Abi613/ESC/PCB/esc/Components/PolyFuse/README.md

Folyfuse model from here

https://eu.mouser.com/ProductDetail/Littelfuse/1206L035YR?qs=PWhpLWeW8wd%2F%252B9d2B1EXww%3D%3D
