Abi613/ESC/PCB/esc/Components/XL7015/README.md

Footprint and 3D model XL7015 from here

https://www.snapeda.com/parts/XL7015/XLSEMI/view-part/
