Abi613/ESC/PCB/esc/Components/Arduino/Arduino_Nano.STEP

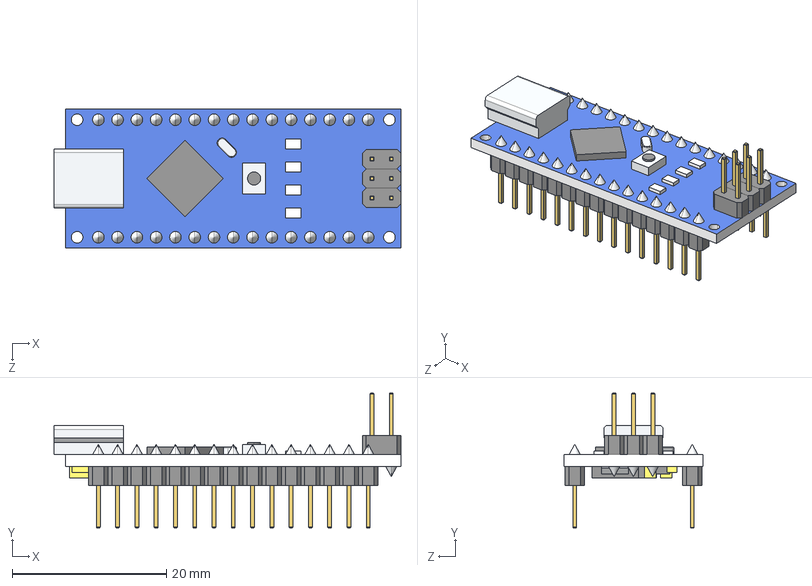
[picture p1: CAD file, 2025-10-23]
PCB/esc/Components/Arduino/Arduino_Nano.STEP
45.0 x 17.5 x 18.0 mm
