Abi613/ESC/PCB/esc/Components/CDRH104RNP/CDRH104RNP-150NC.STEP

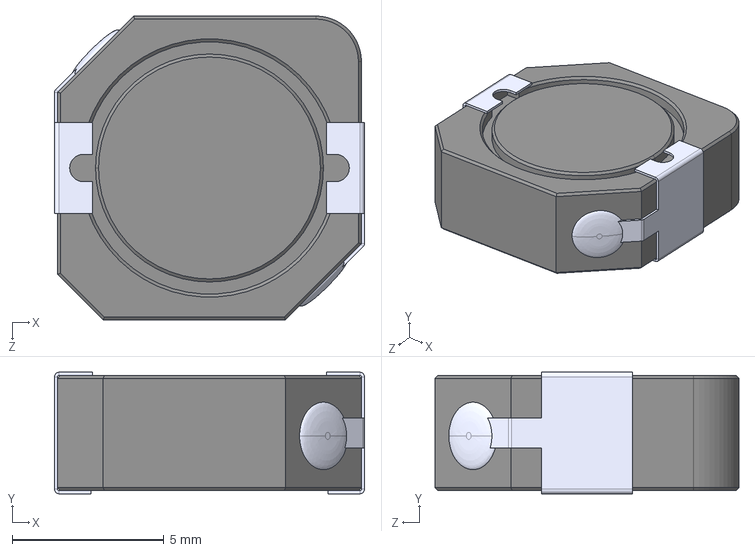
[picture p2: CAD file, 2025-10-23]
PCB/esc/Components/CDRH104RNP/CDRH104RNP-150NC.STEP
10.2 x 4.00 x 10.0 mm
