Abi613/ESC/PCB/esc/Components/Fuse Clips/3522-2--3DModel-STEP-56544.STEP

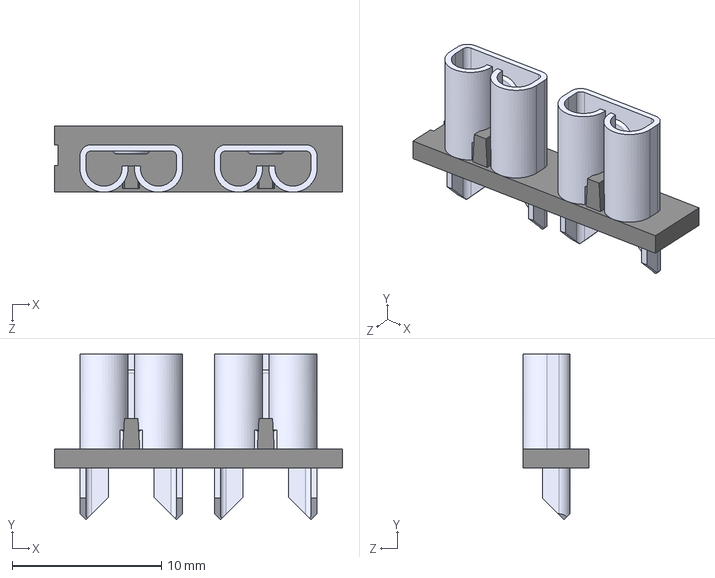
[picture p3: CAD file, 2025-10-23]
PCB/esc/Components/Fuse Clips/3522-2--3DModel-STEP-56544.STEP
19.3 x 11.1 x 4.45 mm
