Abi613/ESC/PCB/esc/Components/XL7015/XL7015.step

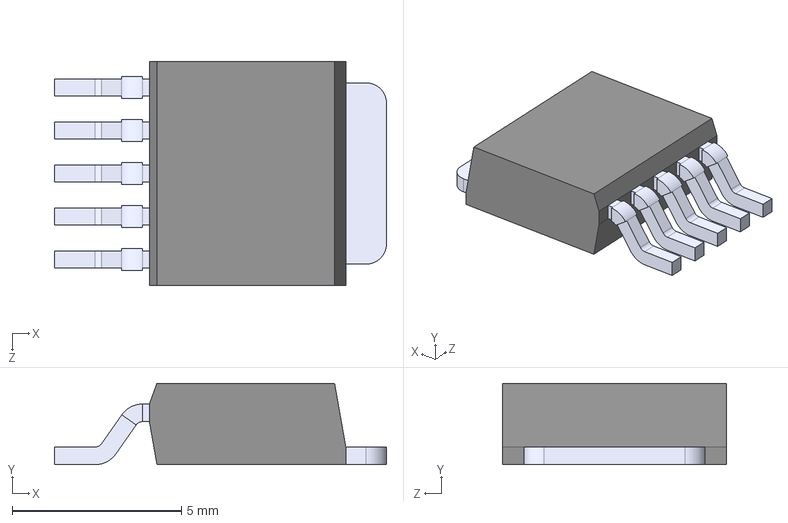
[picture p4: CAD file, 2025-10-23]
PCB/esc/Components/XL7015/XL7015.step
9.80 x 2.40 x 6.60 mm
