Abi613/ESC/PCB/esc/Components/PolyFuse/1206L035YR.stp

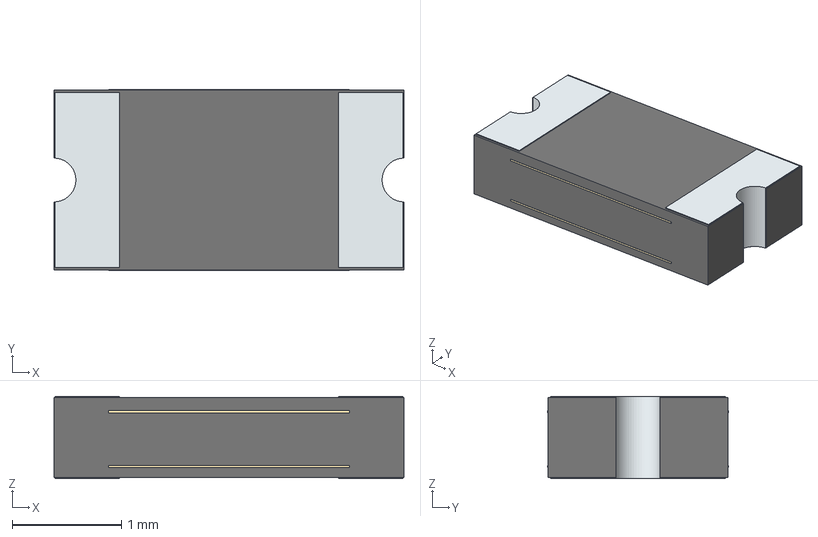
[picture p5: CAD file, 2025-10-23]
PCB/esc/Components/PolyFuse/1206L035YR.stp
3.20 x 1.65 x 0.75 mm
solidIntersect
Terminal
