Abi613/ESC/PCB/esc/Inverter.kicad_pcb

## KiCad design PCB/esc/Inverter.kicad_pcb (2025-11-30)

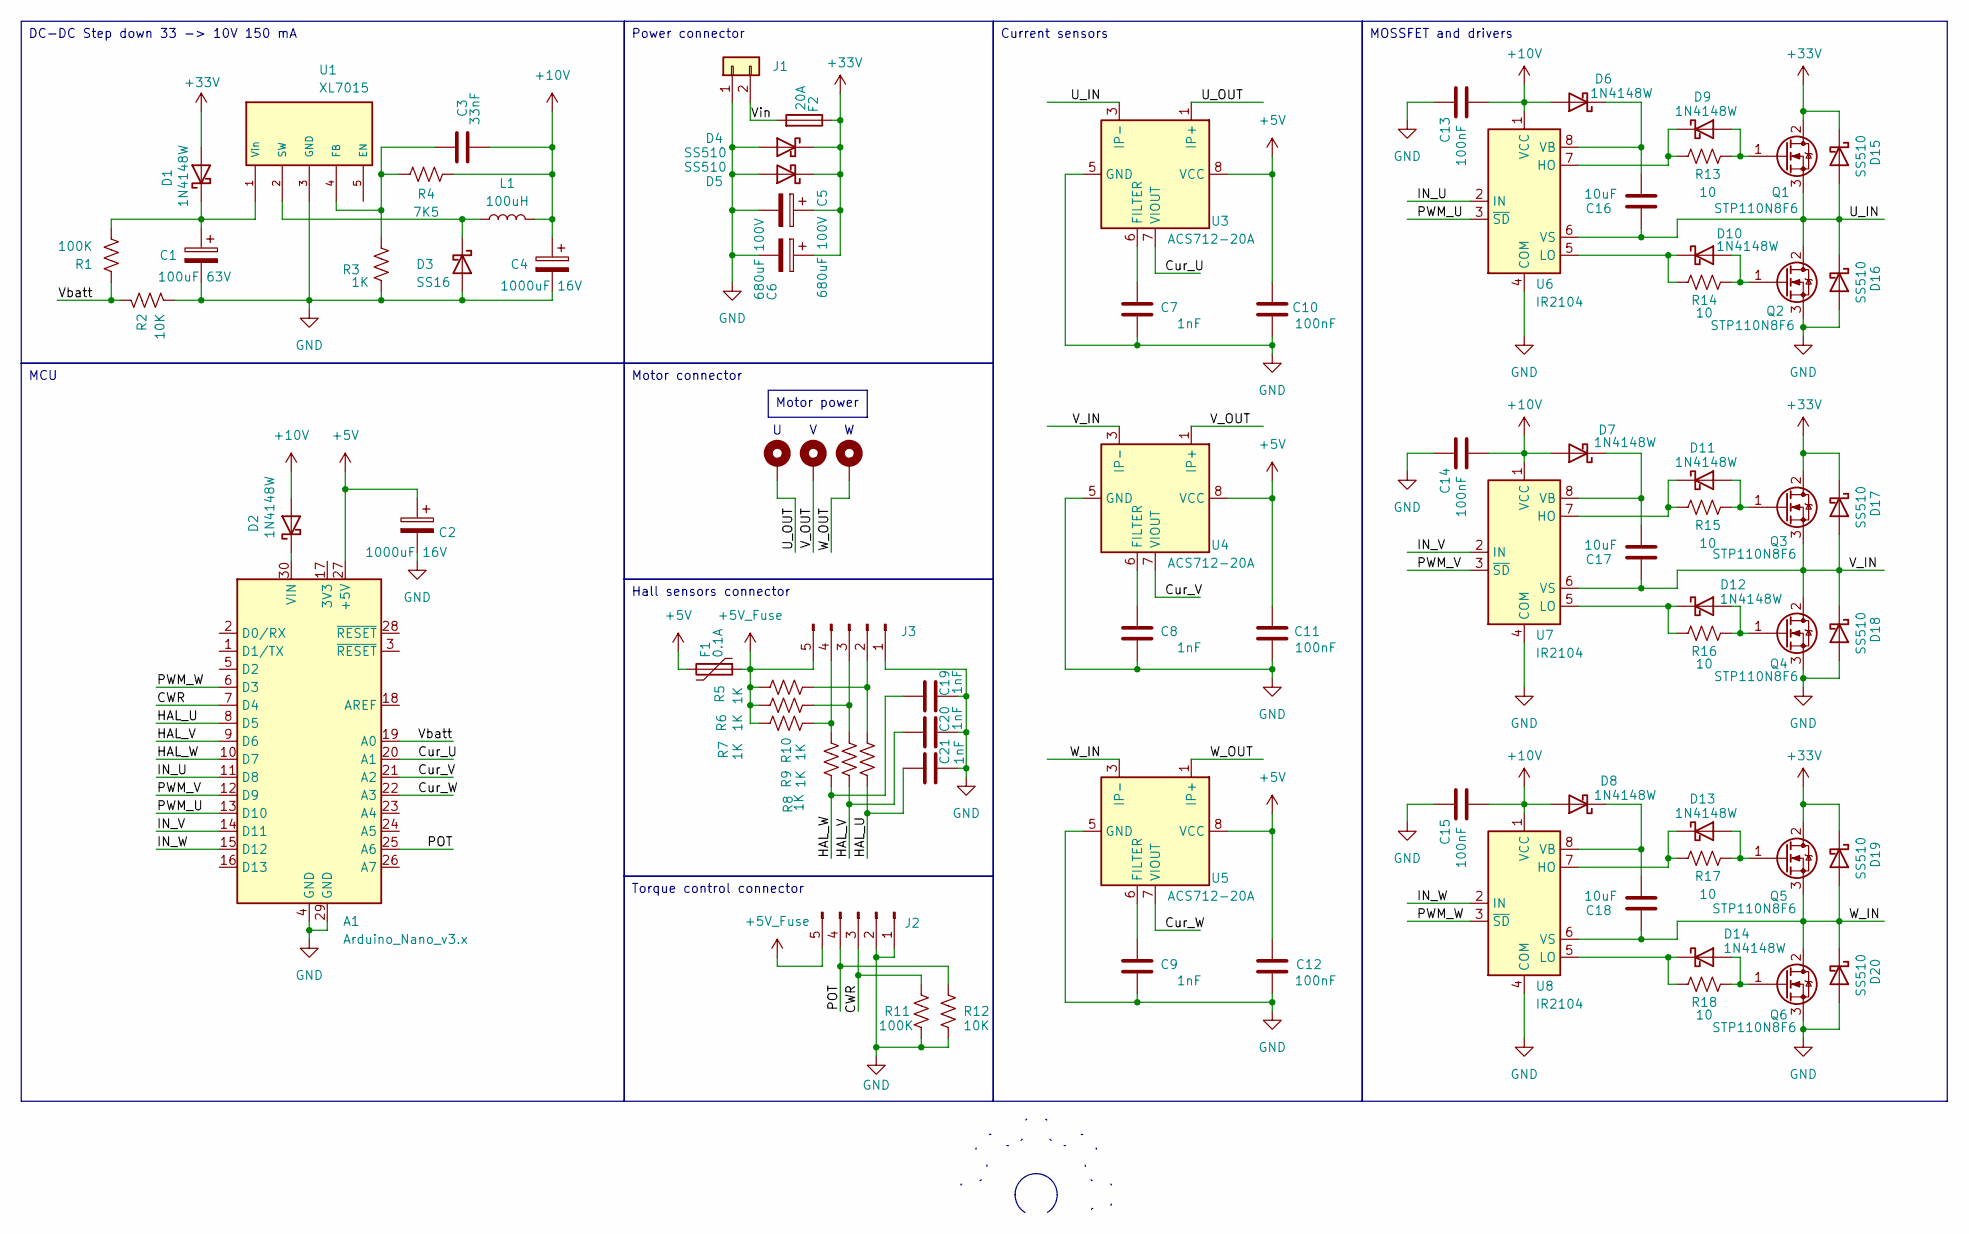
[picture p6: schematic Inverter.kicad_sch, Simple BLDC motor controller]

Parts:
A1: Arduino_Nano_v3.x; Arduino_Nano
C1: 100uF 63V; CP_Elec_10x10.5
C2, C4: 1000uF 16V; CP_Elec_10x10.5
C3: 33nF; C_0805_2012Metric_Pad1.18x1.45mm_HandSolder
C5, C6: 680uF 100V; CP_Radial_D16.0mm_P7.50mm
C7, C8, C9, C19, C20, C21: 1nF; C_0805_2012Metric_Pad1.18x1.45mm_HandSolder
C10, C11, C12, C13, C14, C15: 100nF; C_0805_2012Metric_Pad1.18x1.45mm_HandSolder
C16, C17, C18: 10uF; C_0805_2012Metric_Pad1.18x1.45mm_HandSolder
D1, D2, D6, D7, D8, D9, D10, D11, D12, D13, D14: 1N4148W; Nexperia_CFP3_SOD-123W
D3: SS16; D_SMA_Handsoldering
D4, D5, D15, D16, D17, D18, D19, D20: SS510; ST_D_SMC
F1: 0.1A; Fuse_1206_3216Metric
F2: 20A; FUSE_3522-2
J1: Conn_01x02; AMASS_XT60-M_1x02_P7.20mm_Vertical
J2, J3: Conn_01x05_Pin; JST_XH_B5B-XH-A_1x05_P2.50mm_Vertical
L1: 100uH; L_10.4x10.4_H4.8
Q1, Q2, Q3, Q4, Q5, Q6: STP110N8F6; TO-220-3_Horizontal_TabUp
R1, R11: 100K; R_0805_2012Metric_Pad1.20x1.40mm_HandSolder
R2, R12: 10K; R_0805_2012Metric_Pad1.20x1.40mm_HandSolder
R3, R5, R6, R7, R8, R9, R10: 1K; R_0805_2012Metric_Pad1.20x1.40mm_HandSolder
R4: 7K5; R_0805_2012Metric_Pad1.20x1.40mm_HandSolder
R13, R14, R15, R16, R17, R18: 10; R_0805_2012Metric_Pad1.20x1.40mm_HandSolder
U1: XL7015; TO-252-5_TabPin3
U2: MountingHole_Pad; MountingHole_2.2mm_M2_Pad
U3, U4, U5: ACS712-20A; SOIC-8_3.9x4.9mm_P1.27mm
U6, U7, U8: IR2104; SOIC-8_3.9x4.9mm_P1.27mm
V1: MountingHole_Pad; MountingHole_2.2mm_M2_Pad
W1: MountingHole_Pad; MountingHole_2.2mm_M2_Pad

Connections:
+5V: A1.27 (+5V), C2.1, C10.1, C11.1, C12.1, F1.2, U3.8 (VCC), U4.8 (VCC), U5.8 (VCC)
+5V_Fuse: F1.1, J2.5, J3.5, R5.2, R6.2, R7.2
+10V: C3.2, C4.1, C13.2, C14.2, C15.2, D2.2 (A), D6.2 (A), D7.2 (A), D8.2 (A), L1.2, R4.1, U6.1 (VCC), U7.1 (VCC), U8.1 (VCC)
+33V: C5.1, C6.1, D1.2 (A), D4.1 (K), D5.1 (K), D15.1 (K), D17.1 (K), D19.1 (K), F2.1, Q1.2 (D), Q3.2 (D), Q5.2 (D)
/CWR: A1.7 (D4), J2.3, R11.2
/Cur_U: A1.20 (A1), U3.7 (VIOUT)
/Cur_V: A1.21 (A2), U4.7 (VIOUT)
/Cur_W: A1.22 (A3), U5.7 (VIOUT)
/HAL_U: A1.8 (D5), C21.1, R10.1
/HAL_V: A1.9 (D6), C20.1, R9.1
/HAL_W: A1.10 (D7), C19.1, R8.1
/IN_U: A1.11 (D8), U6.2 (IN)
/IN_V: A1.14 (D11), U7.2 (IN)
/IN_W: A1.15 (D12), U8.2 (IN)
/POT: A1.25 (A6), J2.4, R12.2
/PWM_U: A1.13 (D10), U6.3 (~SD)
/PWM_V: A1.12 (D9), U7.3 (~SD)
/PWM_W: A1.6 (D3), U8.3 (~SD)
/U_IN: C16.1, D15.2 (A), D16.1 (K), Q1.3 (S), Q2.2 (D), U3.3 (IP-), U3.4 (IP-), U6.6 (VS)
/U_OUT: U2.1, U3.1 (IP+), U3.2 (IP+)
/V_IN: C17.1, D17.2 (A), D18.1 (K), Q3.3 (S), Q4.2 (D), U4.3 (IP-), U4.4 (IP-), U7.6 (VS)
/V_OUT: U4.1 (IP+), U4.2 (IP+), V1.1
/Vbatt: A1.19 (A0), R1.2, R2.2
/Vin: F2.2, J1.2
/W_IN: C18.1, D19.2 (A), D20.1 (K), Q5.3 (S), Q6.2 (D), U5.3 (IP-), U5.4 (IP-), U8.6 (VS)
/W_OUT: U5.1 (IP+), U5.2 (IP+), W1.1
GND: A1.4 (GND), A1.29 (GND), C1.2, C2.2, C4.2, C5.2, C6.2, C7.2, C8.2, C9.2, C10.2, C11.2, C12.2, C13.1, C14.1, C15.1, C19.2, C20.2, C21.2, D3.2 (A), D4.2 (A), D5.2 (A), D16.2 (A), D18.2 (A), D20.2 (A), J1.1, J2.1, J2.2, J3.1, Q2.3 (S), Q4.3 (S), Q6.3 (S), R2.1, R3.1, R11.1, R12.1, U1.3 (GND), U3.5 (GND), U4.5 (GND), U5.5 (GND), U6.4 (COM), U7.4 (COM), U8.4 (COM)
unnamed: A1.30 (VIN), D2.1 (K)
unnamed: C1.1, D1.1 (K), R1.1, U1.1 (Vin)
unnamed: D3.1 (K), L1.1, U1.2 (SW)
unnamed: C16.2, D6.1 (K), U6.8 (VB)
unnamed: C17.2, D7.1 (K), U7.8 (VB)
unnamed: C18.2, D8.1 (K), U8.8 (VB)
unnamed: D9.2 (A), Q1.1 (G), R13.1
unnamed: D9.1 (K), R13.2, U6.7 (HO)
unnamed: D10.2 (A), Q2.1 (G), R14.1
unnamed: D10.1 (K), R14.2, U6.5 (LO)
unnamed: D11.2 (A), Q3.1 (G), R15.1
unnamed: D11.1 (K), R15.2, U7.7 (HO)
unnamed: D12.2 (A), Q4.1 (G), R16.1
unnamed: D12.1 (K), R16.2, U7.5 (LO)
unnamed: D13.2 (A), Q5.1 (G), R17.1
unnamed: D13.1 (K), R17.2, U8.7 (HO)
unnamed: D14.2 (A), Q6.1 (G), R18.1
unnamed: D14.1 (K), R18.2, U8.5 (LO)
unnamed: J3.2, R5.1, R10.2
unnamed: J3.3, R6.1, R9.2
unnamed: J3.4, R7.1, R8.2
unnamed: C3.1, R3.2, R4.2, U1.4 (FB)
unnamed: C7.1, U3.6 (FILTER)
unnamed: C8.1, U4.6 (FILTER)
unnamed: C9.1, U5.6 (FILTER)

Notes on the sheet:
Power connector
Current sensors
MOSSFET and drivers
Motor connector
Hall sensors connector
Motor power
MCU
DC-DC Step down 33 -> 10V 150 mA
Torque control connector

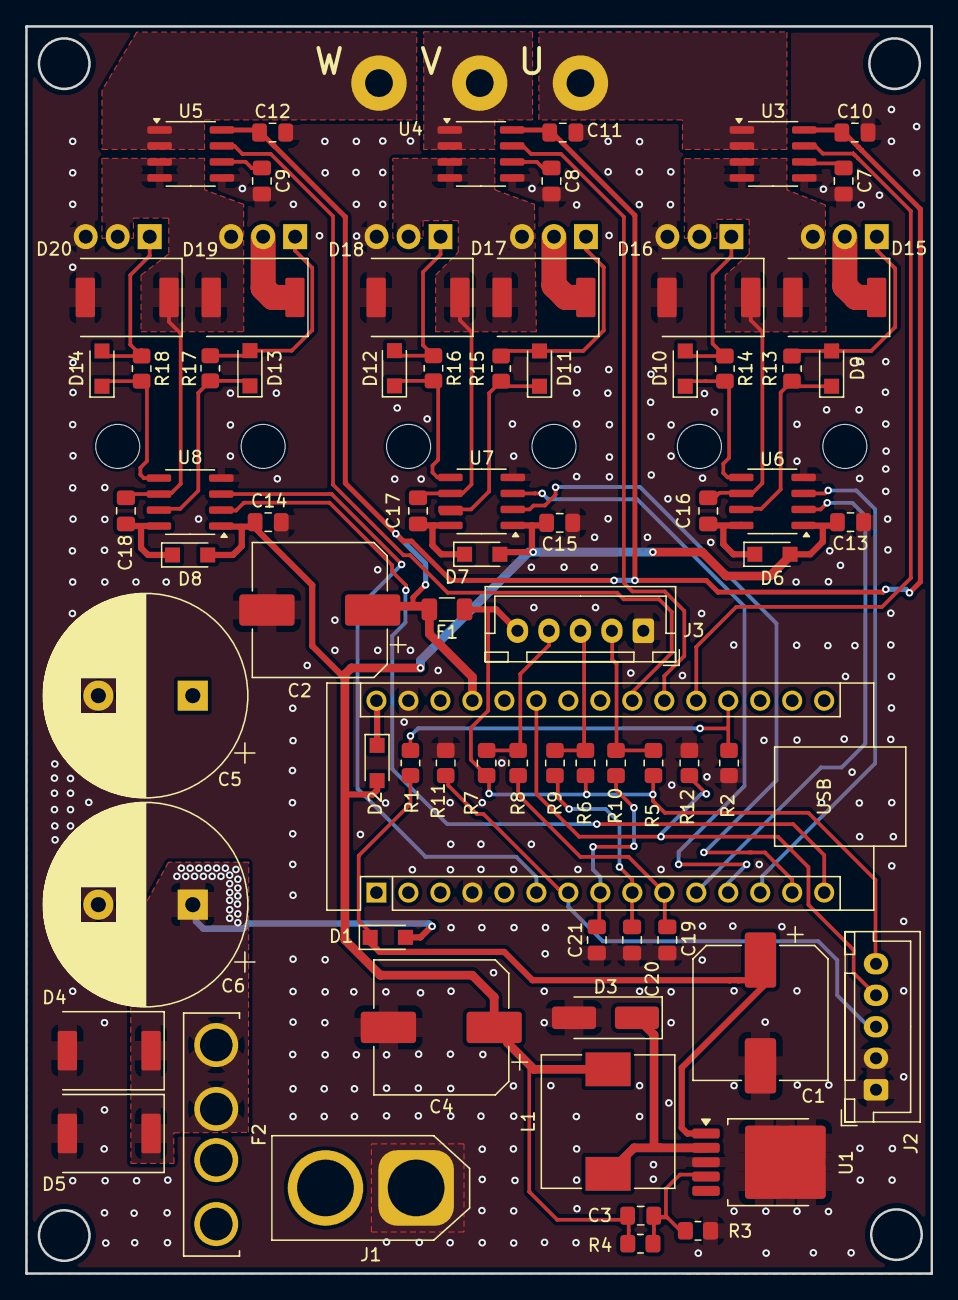
[picture p7: board Inverter.kicad_pcb from above]

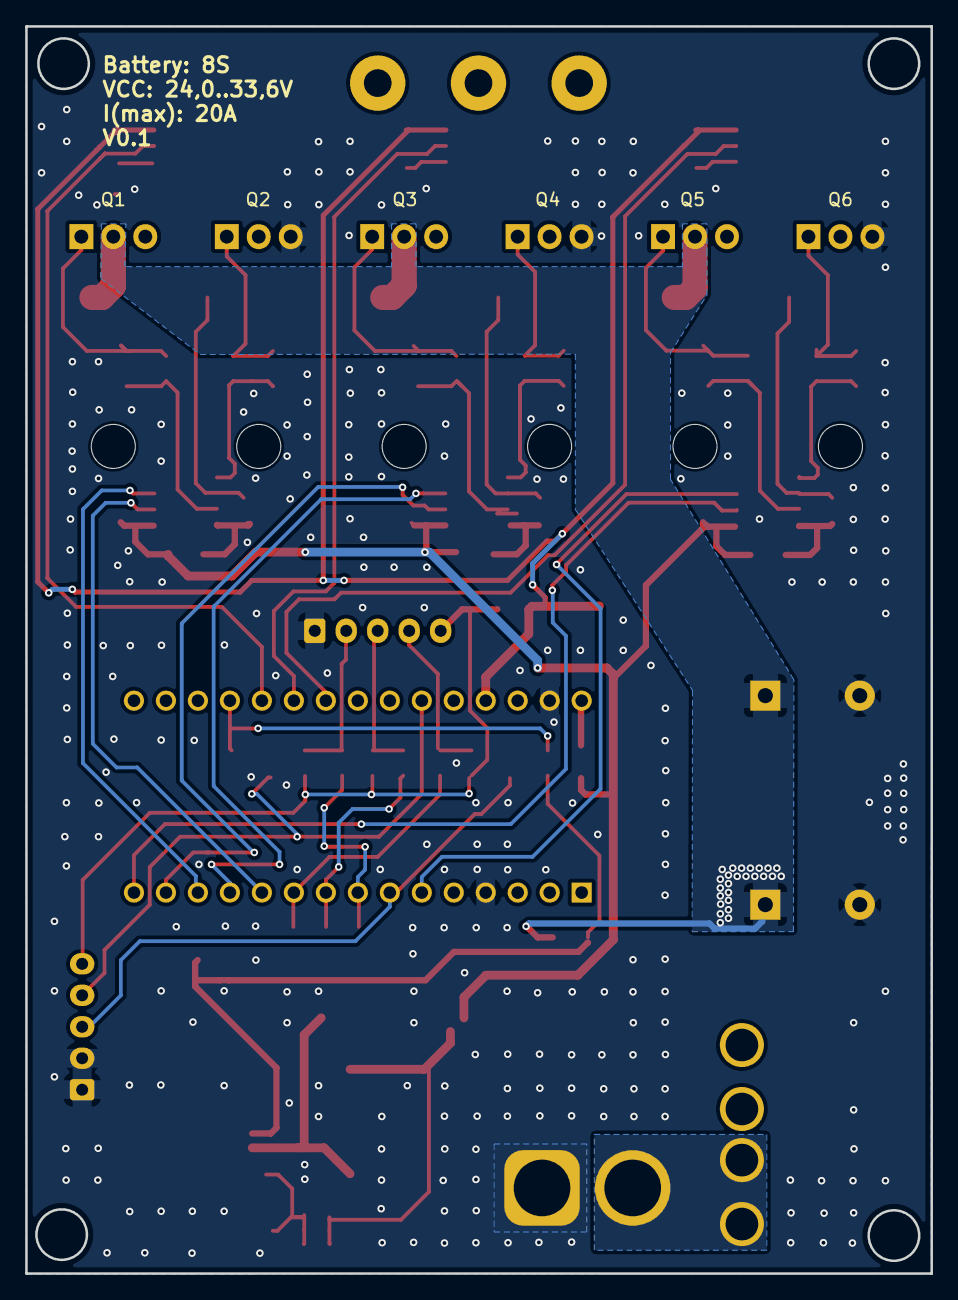
[picture p8: board Inverter.kicad_pcb from below]

Board: 2 copper layers, 71.9 x 99.1 mm, 82 parts (6 on the bottom side), 52 nets.
