Abi613/ESC/(commit log)

2024-05-14 3 Phase ESC
2025-10-23 added PCB and updated the code
    [1206L035YR.stp, 3522-2--3DModel-STEP-56544.STEP, 3522-2.step, Arduino_Nano.STEP, CDRH104RNP-150NC.STEP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]
2025-11-30 ported the code to STM32
    [Inverter.csv, Inverter.kicad_pcb, Inverter.step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]
